tarnan3751/doom-simulation/docs/results/timedemo.md

# Doom timedemo results

Generated by `tools/timedemo_report.py` from the files `scripts/timedemo.sh` writes to
`build/results/`. Every run plays a recorded demo with `-timedemo`, dumps every frame the
program presents, and compares the dump pixel for pixel (after palette lookup) with the
dump of native doomgeneric built from the same patched sources.

Reproduce one row: `make timedemo ENGINE=accurate DEMO=demo3`. Clock: 50 MHz.

## Frames identical to native doomgeneric

| Demo | Map | Frames | golden model (`iss`) | RTL, `fast` | RTL, `accurate` | cycle-exact `model` |
|---|---|---|---|---|---|---|
| demo1 | E1M5 | 5 065 | 5 065 identical, 0 differing | 5 065 identical, 0 differing | 5 065 identical, 0 differing | 5 065 identical, 0 differing |
| demo2 | E1M3 | 3 875 | 3 875 identical, 0 differing | 3 875 identical, 0 differing | 3 875 identical, 0 differing | 3 875 identical, 0 differing |
| demo3 | E1M7 | 2 173 | 2 173 identical, 0 differing | 2 173 identical, 0 differing | 2 173 identical, 0 differing | 2 173 identical, 0 differing |

11 113 frames per engine.

## Accurate engine: SDRAM pin timing, real video scan-out

| | demo1 | demo2 | demo3 |
|---|---|---|---|
| Cycles | 5 768 192 651 | 4 262 874 686 | 2 458 661 186 |
| Instructions retired | 4 531 520 973 | 3 340 619 754 | 1 916 521 883 |
| Instructions per cycle | 0.786 | 0.784 | 0.779 |
| I-cache miss rate | 0.19 % | 0.19 % | 0.21 % |
| D-cache miss rate | 5.48 % | 5.69 % | 5.58 % |
| Conditional branches mispredicted | 8.69 % | 8.53 % | 8.63 % |
| Jumps mispredicted | 8.98 % | 8.43 % | 9.68 % |
| Frames presented | 5 065 | 3 875 | 2 173 |
| Cycles per frame (first to last frame) | 1 133 781 | 1 093 366 | 1 119 626 |
| **Frames per second at 50 MHz** (first to last frame) | **44.10** | **45.73** | **44.66** |
| Doom's own report | timed 5026 gametics in 4024 realtics (43.71 fps) | timed 3836 gametics in 2970 realtics (45.20 fps) | timed 2134 gametics in 1707 realtics (43.75 fps) |
| SDRAM row activations | 133 693 740 | 102 289 691 | 58 239 626 |
| SDRAM protocol/timing violations | 0 | 0 | 0 |
| Serial / video timing errors | 0 / 0 | 0 / 0 | 0 / 0 |
| Scan-out frames checked against the framebuffer | 1 654 | 1 056 | 725 |
| ... of which different | 0 | 0 | 0 |
| Scan-out frames not checkable (framebuffer changed meanwhile) | 5 211 | 4 017 | 2 201 |
| Simulation speed (million cycles per wall-clock second) | 9.1 | 8.7 | 11.1 |

## Fast engine: same CPU and caches, ideal memory

| | demo1 | demo2 | demo3 |
|---|---|---|---|
| Cycles | 5 391 810 465 | 3 974 221 733 | 2 290 109 209 |
| Instructions retired | 4 526 114 346 | 3 335 212 927 | 1 911 115 042 |
| Instructions per cycle | 0.839 | 0.839 | 0.835 |
| I-cache miss rate | 0.19 % | 0.19 % | 0.21 % |
| D-cache miss rate | 5.48 % | 5.69 % | 5.58 % |
| Conditional branches mispredicted | 8.74 % | 8.59 % | 8.73 % |
| Jumps mispredicted | 8.98 % | 8.43 % | 9.68 % |
| Frames presented | 5 065 | 3 875 | 2 173 |
| Cycles per frame (first to last frame) | 1 061 231 | 1 021 191 | 1 046 183 |
| **Frames per second at 50 MHz** (first to last frame) | **47.12** | **48.96** | **47.79** |
| Doom's own report | timed 5026 gametics in 3766 realtics (46.71 fps) | timed 3836 gametics in 2773 realtics (48.41 fps) | timed 2134 gametics in 1594 realtics (46.85 fps) |
| Simulation speed (million cycles per wall-clock second) | 11.1 | 11.8 | 10.5 |

## Cycle-exact model: the accurate machine's timing in software, no RTL

| | demo1 | demo2 | demo3 |
|---|---|---|---|
| Cycles | 5 768 192 651 | 4 262 874 686 | 2 458 661 186 |
| Instructions retired | 4 531 520 973 | 3 340 619 754 | 1 916 521 883 |
| Instructions per cycle | 0.786 | 0.784 | 0.779 |
| I-cache miss rate | 0.19 % | 0.19 % | 0.21 % |
| D-cache miss rate | 5.48 % | 5.69 % | 5.58 % |
| Conditional branches mispredicted | 8.69 % | 8.53 % | 8.63 % |
| Jumps mispredicted | 8.98 % | 8.43 % | 9.68 % |
| Frames presented | 5 065 | 3 875 | 2 173 |
| Cycles per frame (first to last frame) | 1 133 781 | 1 093 366 | 1 119 626 |
| **Frames per second at 50 MHz** (first to last frame) | **44.10** | **45.73** | **44.66** |
| Doom's own report | timed 5026 gametics in 4024 realtics (43.71 fps) | timed 3836 gametics in 2970 realtics (45.20 fps) | timed 2134 gametics in 1707 realtics (43.75 fps) |
| Simulation speed (million cycles per wall-clock second) | 53.9 | 75.6 | 72.7 |

"First to last frame" excludes program start-up before the first frame. Doom's own report
divides game tics by its cycle-counter clock over the whole demo, including level loading.
Simulation speed depends on what else the machine was doing during the run.

## Lockstep run against the cycle-exact model

demo3 on the accurate engine with the `model` engine running alongside; for every retired
instruction the retire record, the cycle it retires in and all eleven counters are compared,
with no overrides for MMIO or counter reads; frames and serial bytes with their cycles too:

- instructions compared: 1 916 521 948, deviations: 0 (a deviation ends the run)
- frames identical to native: 2 173 of 2 173

## Lockstep run against the golden model

demo3 on the accurate engine with the golden model executing every retired instruction
alongside the RTL and comparing program counter, instruction, register write, memory
access and next PC:

- instructions compared: 1 916 516 616, mismatches: 0 (a mismatch ends the run)
- frames compared between the two models at each flip: 2 173
- frames identical to native: 2 173 of 2 173
- SDRAM violations: 0; scan-out frames checked: 725, different: 0
