tarnan3751/doom-simulation/docs/images/testpattern-accurate.png

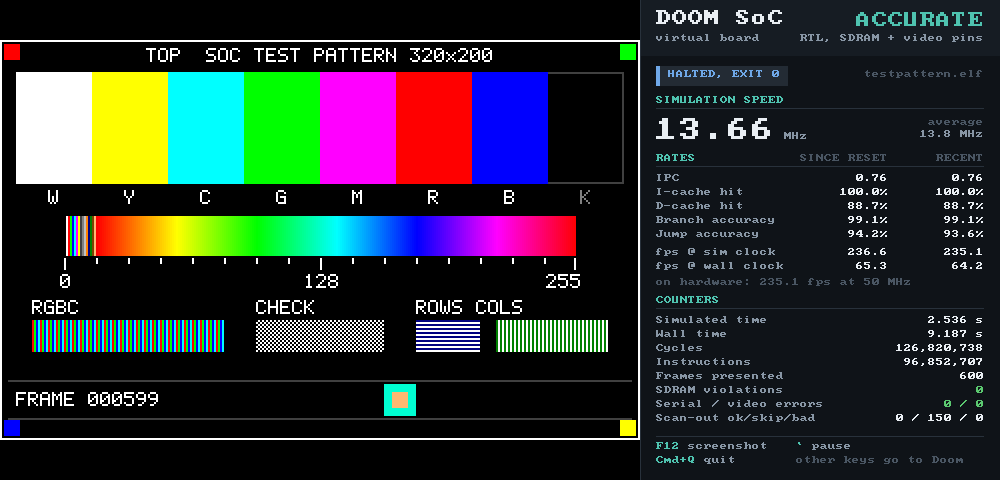
docs/images/testpattern-accurate.png
