tarnan3751/doom-simulation/rtl/core/rv32_alu.sv

// rv32_alu - single-cycle integer ALU (EX stage).
`default_nettype none

module rv32_alu
    import rv32_pkg::*;
(
    input  alu_op_e     op,
    input  logic [31:0] a,
    input  logic [31:0] b,
    output logic [31:0] y
);
    logic [4:0] shamt;
    assign shamt = b[4:0];

    always_comb begin
        unique case (op)
            ALU_ADD:  y = a + b;
            ALU_SUB:  y = a - b;
            ALU_SLL:  y = a << shamt;
            ALU_SLT:  y = {31'b0, $signed(a) < $signed(b)};
            ALU_SLTU: y = {31'b0, a < b};
            ALU_XOR:  y = a ^ b;
            ALU_SRL:  y = a >> shamt;
            ALU_SRA:  y = $unsigned($signed(a) >>> shamt);
            ALU_OR:   y = a | b;
            ALU_AND:  y = a & b;
            default:  y = 32'b0;
        endcase
    end

endmodule

`default_nettype wire
